khyarul/SENTINEL-MARK-II-QUEST/README.md

   
# SENTINEL MARK II (QUEST) - Line Follower Path Planning + Oled I2C User Interface
- Arduino compatible based on Maple Mini board (STM32F103CBT6)
- Burn and update firmware via USB-OTG
- BTS7960 motor driver 2 port + encoder
- OLED I2C SSD1306 128x64
- external eeprom (24LCxxx)
- 2 port for mini servo 5V
- 1 port for extinguisher motor (adjustable voltage using PWM) 
- external serial port (Serial1)

### Schematic (made using Kicad)
available in "Schematic" folder:
- SENTINEL Mark II - Quest.pro (Kicad Project)

### Gerber (3 board):
- Core + Driver motor: [Here](https://www.pcbway.com/project/shareproject/SENTINEL_mark_II__QUEST___Core___motor_driver_.html)
- Button + LCD: [Here](https://www.pcbway.com/project/shareproject/SENTINEL_mark_II__QUEST___button___eeprom___lcd_.html)
- Sensor: [Here](https://www.pcbway.com/project/shareproject/SENTINEL_mark_II__QUEST___Sensor_.html)

### Board Preview
SENTINEL Mark II - Quest
SENTINEL Mark II - Quest
SENTINEL Mark II - Quest bott
SENTINEL Mark II - Quest top
SENTINEL Mark II - Quest
SENTINEL Mark II - Quest
