khyarul/SENTINEL-MARK-II-QUEST/BOM List_mark2_rev0.xls

Ref | Qnty | Value | Battery | DC MOTOR | Bracket
C1, C5, C6, C9, C13, C18, C21, C22, C23, C24, C25, CM6 | 12 | 0805 100nF 50V | LiPo 3 cell 12.6V ~850mAh | 370 series or micro motor 12V | Acrylic
C2, C3, C4 | 3 | 0805 22uF 16V
C7, C8 | 2 | 0805 33uF 10V
C10 | 1 | 0805 3.9nF
C11, C12, C19, C20 | 4 | 0805 33pF
C14, C15, C16, C17 | 4 | 0805 1uF
CM1, CM2, CM3, CM5 | 4 | 0805 470nF 16V
CM4 | 1 | Cap Alu 100uF 16V ~6mmx8mm
D1, DM3 | 2 | SS34
D3 | 1 | SS54
D4 | 1 | 0805 LED
D5, DM2 | 2 | SS14
DM1 | 1 | Zener 5.1V
FB1, FB2, FB3, FB4, FB5, FB6, FB7 | 7 | 0805 Ferrite Bead 1A
FP1 | 1 | 1206 PTC fuse 2A
J1, J2, J3, J4, J5, J7, J8, J10, JP1, JM2 | 10 | Header Male Vertical 2.54mm
J6, J9 | 2 | Header Male Vertical 2.00mm
J11 | 1 | USB mini
JM1, JM3 | 2 | JST PH Horizontal 2.00mm
L1 | 1 | 10uH/4A ~7mm*7mm*3mm
LCD1 | 1 | LCD I2C OLED 128x64
LL1, LL2, LL3, LL4, LL5, LL6, LL7, LL8, LL9, LL10, LL11, LL12, LL13, LL14 | 14 | LED 3mm clear (white or green)
P1, P2, P3, P4, P5, P6, P7, P8, P9, P10, P11, P12, P13, P14 | 14 | photodiode 3mm
Q1, QM1 | 2 | MMBT3904
Q2 | 1 | MMBT3906
QM2 | 1 | AO3401
R1, R6, R8, R9, R12 | 5 | 0805 10K
R2 | 1 | 0805 100K
R3 | 1 | 0805 33K
R4, R20, R21, R22, R23, R24, R25, R26, R27, R28, R29, R30, R31, R32, R33 | 15 | 0805 6K8
R5, R10, R11, R34 | 4 | 0805 2K2
R7 | 1 | 0805 330
R13, R19 | 2 | 0805 1K
R14 | 1 | 0805 1K5
R15, R16 | 2 | 0805 0-22
R17, R18 | 2 | 0805 100
RM1, RM2, RM4, RM5, RM6, RM7, RM10, RM11, RM13, RM14 | 10 | 0805 10K
RM3, RM8, RM12, RM15 | 4 | SR
S1, | 1 | Slide switch 2.54mm
SW1, SW2, SW3, SW4, SW5, SW6, SW7 | 7 | SMD Push button max. 6mmx6mm
U1 | 1 | LM1117 3.3V / LD1117S33TR
U2 | 1 | MP2307
U3 | 1 | STM32F103CBTx
U4 | 1 | 24LC256 EEPROM
U5, U6 | 2 | 74HC4051 Multiplexer
UM1, UM2, UM3, UM4 | 4 | BTS7960
Y1 | 1 | 8MHz/20pF
