khyarul/SENTINEL-MARK-II-QUEST/(threads)

Thread 1 (2023-11-26):

Request for Assistance: Open Source Project Issues and Component Identification Challenge

Rakeshtsg, 2023-11-26:
Hello,

Firstly, thank you for your contribution to open-source projects. I'm currently encountering significant problems in RM3, RM8, RM12, and RM15|4|SR, where "resistor" was declared as SR. I'm unsure about SR's significance, so kindly provide a brief explanation of this issue.

Additionally, I'm having difficulty identifying components in images with components. Could you please share the file in .kicad_pcb format? Thank you.

Best regards.
issue.1
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
