khyarul/SENTINEL-MARK-II-QUEST/Schematic/LCD+Button+EEPROM.sch

## KiCad design Schematic/LCD+Button+EEPROM.sch (2020-10-01)

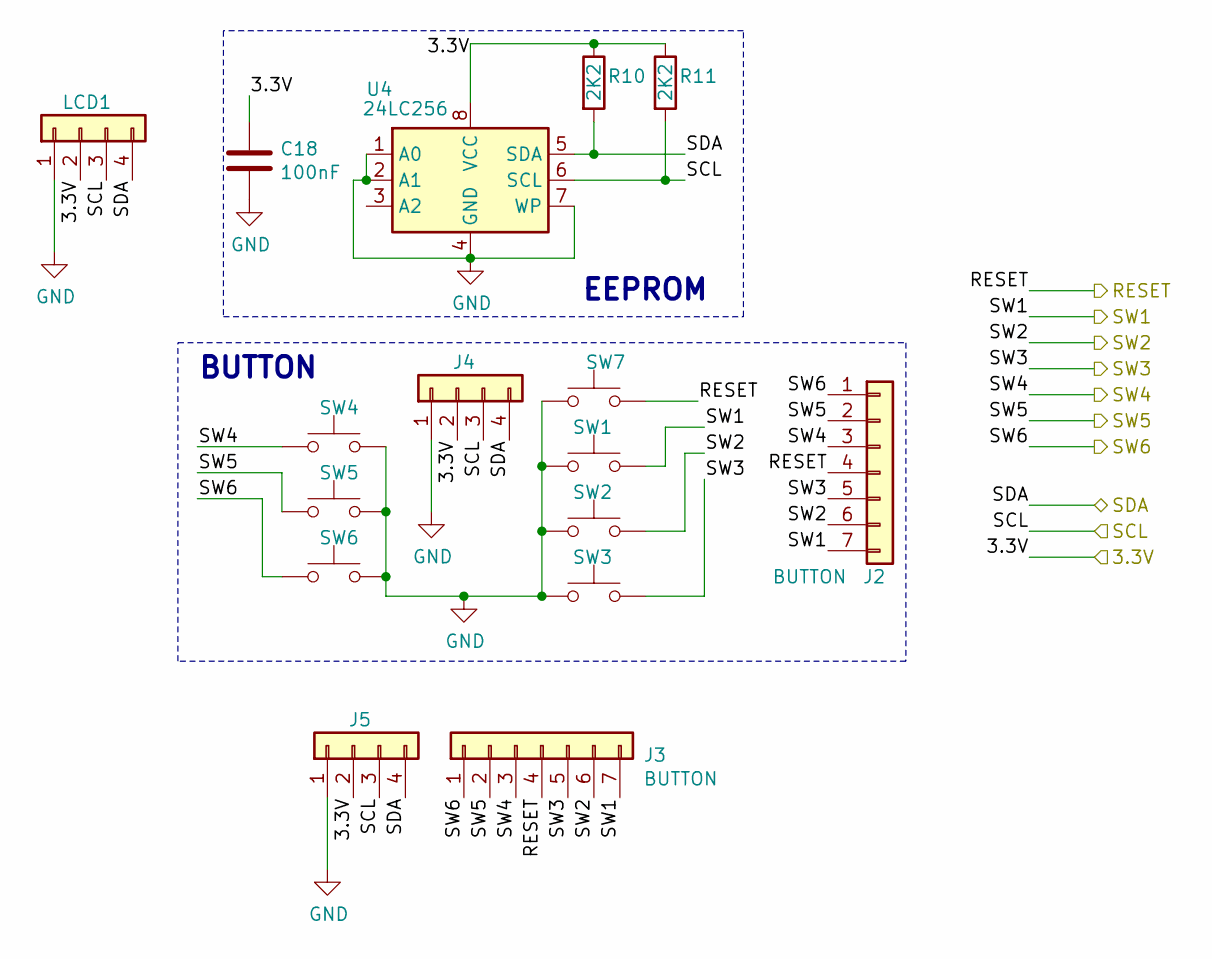
[picture p1: schematic LCD+Button+EEPROM.sch]

Parts:
C18: 100nF; C_0805_2012Metric
J2: BUTTON; PinSocket_1x07_P2.54mm_Vertical
J3: BUTTON; PinHeader_1x07_P2.54mm_Vertical
J4: Conn_01x04; PinHeader_1x04_P2.54mm_Vertical
J5: Conn_01x04; PinSocket_1x04_P2.54mm_Vertical
LCD1: LCD; OLED_I2C_128x64
R10, R11: 2K2; R_0805_2012Metric
SW1: B1; Push_button_silicon_mute
SW2: B2; Push_button_silicon_mute
SW3: B3; Push_button_silicon_mute
SW4: B4; Push_button_silicon_mute
SW5: B5; Push_button_silicon_mute
SW6: B6; Push_button_silicon_mute
SW7: RESET; Push_button_silicon_mute
U4: 24LC256; SO-8_3.9x4.9mm_P1.27mm

Connections:
3.3V: C18.1, J4.2, J5.2, LCD1.2, R10.1, R11.1, U4.8 (VCC)
GND: C18.2, J4.1, J5.1, LCD1.1, SW1.1, SW2.1, SW3.1, SW4.2, SW5.2, SW6.2, SW7.1, U4.1 (A0), U4.2 (A1), U4.4 (GND), U4.7 (WP)
RESET: J2.4, J3.4, SW7.2
SCL: J4.3, J5.3, LCD1.3, R11.2, U4.6 (SCL)
SDA: J4.4, J5.4, LCD1.4, R10.2, U4.5 (SDA)
SW1: J2.7, J3.7, SW1.2
SW2: J2.6, J3.6, SW2.2
SW3: J2.5, J3.5, SW3.2
SW4: J2.3, J3.3, SW4.1
SW5: J2.2, J3.2, SW5.1
SW6: J2.1, J3.1, SW6.1

Notes on the sheet:
EEPROM
BUTTON
