khyarul/SENTINEL-MARK-II-QUEST/Schematic/Motor Driver+Extinguisher.sch

## KiCad design Schematic/Motor Driver+Extinguisher.sch (2020-10-01)

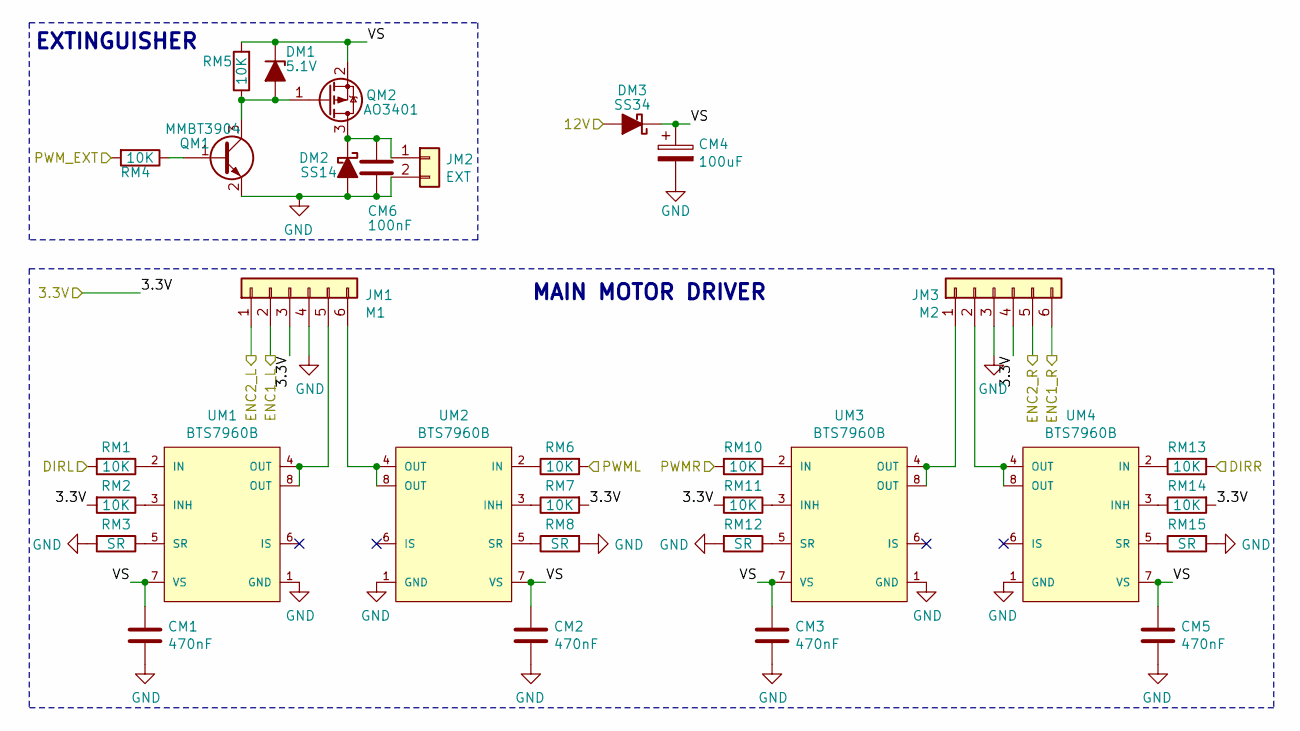
[picture p2: schematic Motor Driver+Extinguisher.sch]

Parts:
CM1, CM2, CM3, CM5: 470nF; C_0805_2012Metric
CM4: 100uF; CP_Elec_6.3x7.7
CM6: 100nF; C_0805_2012Metric
DM1: 5.1V; D_SOD-123
DM2: SS14; D_SMA
DM3: SS34; D_SMA
JM1: M1; JST_PH_S6B-PH-K_1x06_P2.00mm_Horizontal
JM2: EXT; PinHeader_1x02_P2.54mm_Vertical
JM3: M2; JST_PH_S6B-PH-K_1x06_P2.00mm_Horizontal
QM1: MMBT3904; SOT-23
QM2: AO3401; SOT-23
RM1, RM2, RM4, RM5, RM6, RM7, RM10, RM11, RM13, RM14: 10K; R_0805_2012Metric
RM3, RM8, RM12, RM15: SR; R_0805_2012Metric
UM1, UM2, UM3, UM4: BTS7960B; Infineon-BTS7960B-Level_A

Connections:
3.3V: JM1.3, JM3.4, RM2.2, RM7.2, RM11.2, RM14.2
12V: DM3.2 (A)
DIRL: RM1.2
DIRR: RM13.2
ENC1_L: JM1.2
ENC1_R: JM3.6
ENC2_L: JM1.1
ENC2_R: JM3.5
GND: CM1.2, CM2.2, CM3.2, CM4.2, CM5.2, CM6.2, DM2.2 (A), JM1.4, JM2.2, JM3.3, QM1.2 (E), RM3.2, RM8.2, RM12.2, RM15.2, UM1.1 (GND), UM2.1 (GND), UM3.1 (GND), UM4.1 (GND)
unnamed: CM6.1, DM2.1 (K), JM2.1, QM2.3 (D)
unnamed: DM1.2 (A), QM1.3 (C), QM2.1 (G), RM5.1
unnamed: JM1.5, UM1.4 (OUT), UM1.8 (OUT)
unnamed: JM1.6, UM2.4 (OUT), UM2.8 (OUT)
unnamed: JM3.1, UM3.4 (OUT), UM3.8 (OUT)
unnamed: JM3.2, UM4.4 (OUT), UM4.8 (OUT)
unnamed: QM1.1 (B), RM4.1
unnamed: RM1.1, UM1.2 (IN)
unnamed: RM2.1, UM1.3 (INH)
unnamed: RM3.1, UM1.5 (SR)
unnamed: RM6.1, UM2.2 (IN)
unnamed: RM7.1, UM2.3 (INH)
unnamed: RM8.1, UM2.5 (SR)
unnamed: RM10.1, UM3.2 (IN)
unnamed: RM11.1, UM3.3 (INH)
unnamed: RM12.1, UM3.5 (SR)
unnamed: RM13.1, UM4.2 (IN)
unnamed: RM14.1, UM4.3 (INH)
unnamed: RM15.1, UM4.5 (SR)
PWML: RM6.2
PWMR: RM10.2
PWM_EXT: RM4.2
VS: CM1.1, CM2.1, CM3.1, CM4.1, CM5.1, DM1.1 (K), DM3.1 (K), QM2.2 (S), RM5.2, UM1.7 (VS), UM2.7 (VS), UM3.7 (VS), UM4.7 (VS)

Notes on the sheet:
MAIN MOTOR DRIVER
EXTINGUISHER
