khyarul/SENTINEL-MARK-II-QUEST/Schematic/Power Supply.sch

## KiCad design Schematic/Power Supply.sch (2020-10-23)

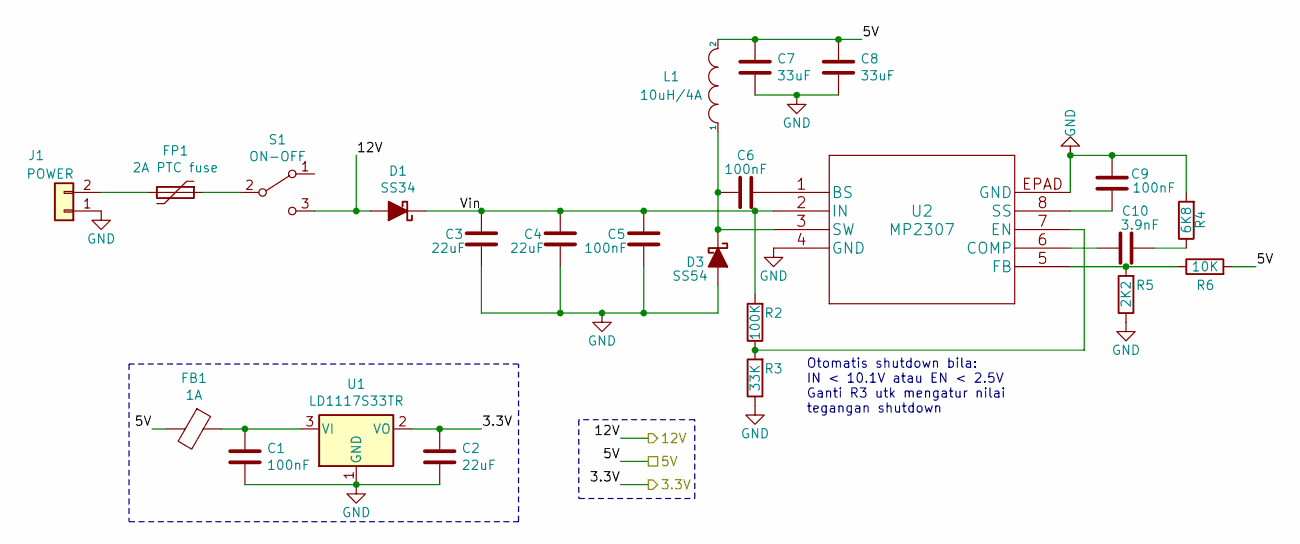
[picture p3: schematic Power Supply.sch]

Parts:
C1, C5, C6, C9: 100nF; C_0805_2012Metric
C2, C3, C4: 22uF; C_0805_2012Metric
C7, C8: 33uF; C_0805_2012Metric
C10: 3.9nF; C_0805_2012Metric
D1: SS34; D_SMA
D3: SS54; D_SMA
FB1: 1A; L_0805_2012Metric
FP1: 2A PTC fuse; Fuse_1206_3216Metric
J1: POWER; PinHeader_1x02_P2.54mm_Vertical
L1: 10uH/4A; L_7.3x7.3_H3.5
R2: 100K; R_0805_2012Metric
R3: 33K; R_0805_2012Metric
R4: 6K8; R_0805_2012Metric
R5: 2K2; R_0805_2012Metric
R6: 10K; R_0805_2012Metric
S1: ON-OFF; switch_slide_2.54
U1: LD1117S33TR; SOT-223-3_TabPin2
U2: MP2307

Connections:
3.3V: C2.1, U1.2 (VO)
5V: C7.1, C8.1, FB1.2, L1.2, R6.2
12V: D1.2 (A), S1.3 (C)
GND: C1.2, C2.2, C3.2, C4.2, C5.2, C7.2, C8.2, C9.2, D3.2 (A), J1.1, R3.1, R4.2, R5.1, U1.1 (GND), U2.4 (GND), U2.EPAD (GND)
unnamed: C1.1, FB1.1, U1.3 (VI)
unnamed: C6.1, U2.1 (BS)
unnamed: C6.2, D3.1 (K), L1.1, U2.3 (SW)
unnamed: C9.1, U2.8 (SS)
unnamed: C10.1, R4.1
unnamed: C10.2, U2.6 (COMP)
unnamed: FP1.1, S1.2 (B)
unnamed: FP1.2, J1.2
unnamed: R2.1, R3.2, U2.7 (EN)
unnamed: R5.2, R6.1, U2.5 (FB)
Vin: C3.1, C4.1, C5.1, D1.1 (K), R2.2, U2.2 (IN)

Notes on the sheet:
Otomatis shutdown bila: IN < 10.1V atau EN < 2.5V Ganti R3 utk mengatur nilai tegangan shutdown
