khyarul/SENTINEL-MARK-II-QUEST/Schematic/SENTINEL Mark II - Quest.sch

## KiCad design Schematic/SENTINEL Mark II - Quest.sch (2020-10-03)

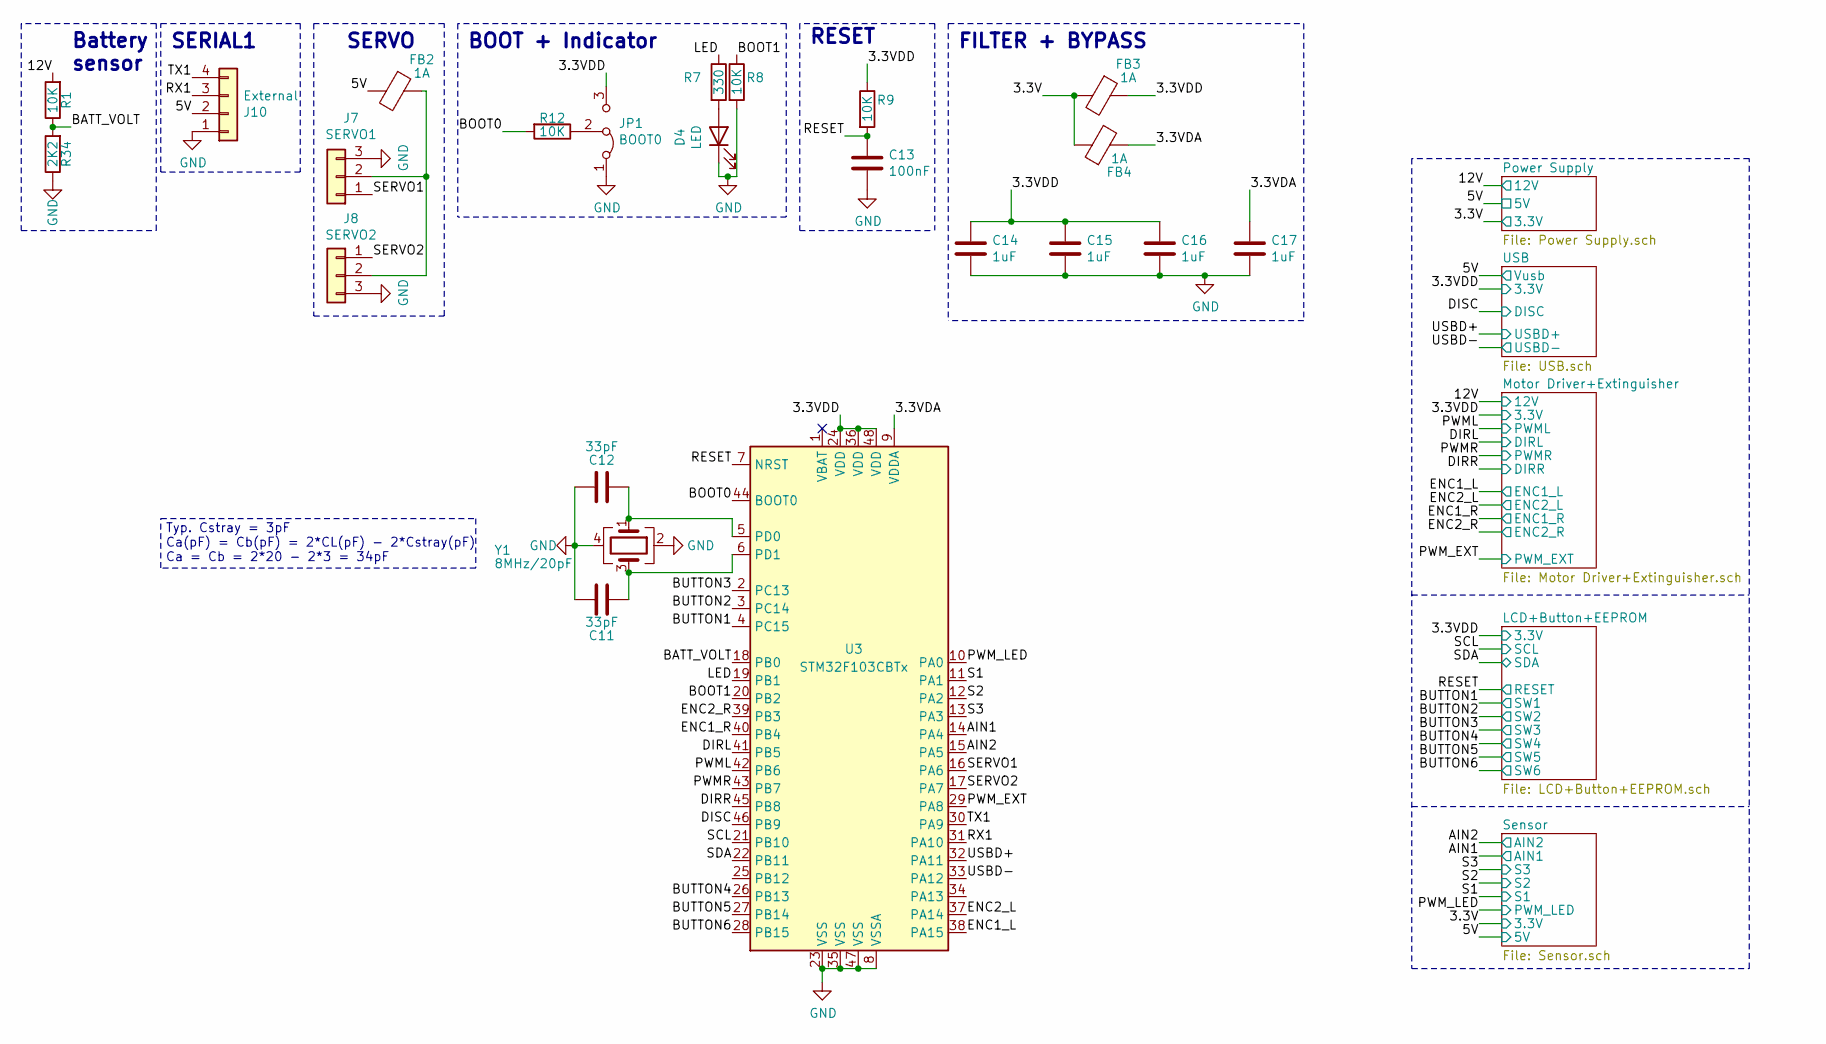
[picture p4: schematic SENTINEL Mark II - Quest.sch]

Parts:
C11, C12: 33pF; C_0805_2012Metric
C13: 100nF; C_0805_2012Metric
C14, C15, C16, C17: 1uF; C_0805_2012Metric
D4: LED; LED_0805_2012Metric
FB2, FB3, FB4: 1A; L_0805_2012Metric
J7: SERVO1; PinHeader_1x03_P2.54mm_Vertical
J8: SERVO2; PinHeader_1x03_P2.54mm_Vertical
J10: External; PinHeader_1x04_P2.54mm_Horizontal
JP1: BOOT0; PinHeader_1x03_P2.54mm_Vertical
R1, R8, R9, R12: 10K; R_0805_2012Metric
R7: 330; R_0805_2012Metric
R34: 2K2; R_0805_2012Metric
U3: STM32F103CBTx; LQFP-48_7x7mm_P0.5mm
Y1: 8MHz/20pF; Crystal_SMD_3225-4Pin_3.2x2.5mm_HandSoldering

Connections:
3.3V: FB3.2, FB4.1
3.3VDA: C17.1, FB4.2, U3.9 (VDDA)
3.3VDD: C14.1, C15.1, C16.1, FB3.1, JP1.3 (B), R9.1, U3.24 (VDD), U3.36 (VDD), U3.48 (VDD)
5V: FB2.2, J10.2
12V: R1.2
AIN1: U3.14 (PA4)
AIN2: U3.15 (PA5)
BATT_VOLT: R1.1, R34.2, U3.18 (PB0)
BOOT0: R12.2, U3.44 (BOOT0)
BOOT1: R8.1, U3.20 (PB2)
BUTTON1: U3.4 (PC15)
BUTTON2: U3.3 (PC14)
BUTTON3: U3.2 (PC13)
BUTTON4: U3.26 (PB13)
BUTTON5: U3.27 (PB14)
BUTTON6: U3.28 (PB15)
DIRL: U3.41 (PB5)
DIRR: U3.45 (PB8)
DISC: U3.46 (PB9)
ENC1_L: U3.38 (PA15)
ENC1_R: U3.40 (PB4)
ENC2_L: U3.37 (PA14)
ENC2_R: U3.39 (PB3)
GND: C11.1, C12.1, C13.2, C14.2, C15.2, C16.2, C17.2, D4.1 (K), J7.3, J8.3, J10.1, JP1.1 (A), R8.2, R34.1, U3.8 (VSSA), U3.23 (VSS), U3.35 (VSS), U3.47 (VSS), Y1.2, Y1.4
LED: R7.1, U3.19 (PB1)
unnamed: C11.2, U3.6 (PD1), Y1.3
unnamed: C12.2, U3.5 (PD0), Y1.1
unnamed: D4.2 (A), R7.2
unnamed: FB2.1, J7.2, J8.2
unnamed: JP1.2 (C), R12.1
PWML: U3.42 (PB6)
PWMR: U3.43 (PB7)
PWM_EXT: U3.29 (PA8)
PWM_LED: U3.10 (PA0)
RESET: C13.1, R9.2, U3.7 (NRST)
RX1: J10.3, U3.31 (PA10)
S1: U3.11 (PA1)
S2: U3.12 (PA2)
S3: U3.13 (PA3)
SCL: U3.21 (PB10)
SDA: U3.22 (PB11)
SERVO1: J7.1, U3.16 (PA6)
SERVO2: J8.1, U3.17 (PA7)
TX1: J10.4, U3.30 (PA9)
USBD+: U3.32 (PA11)
USBD-: U3.33 (PA12)

Notes on the sheet:
Typ. Cstray = 3pF Ca(pF) = Cb(pF) = 2*CL(pF) - 2*Cstray(pF) Ca = Cb = 2*20 - 2*3 = 34pF
SERVO
FILTER + BYPASS
BOOT + Indicator
RESET
SERIAL1
Battery sensor
