khyarul/SENTINEL-MARK-II-QUEST/Schematic/Sensor.sch

## KiCad design Schematic/Sensor.sch (2020-10-03)

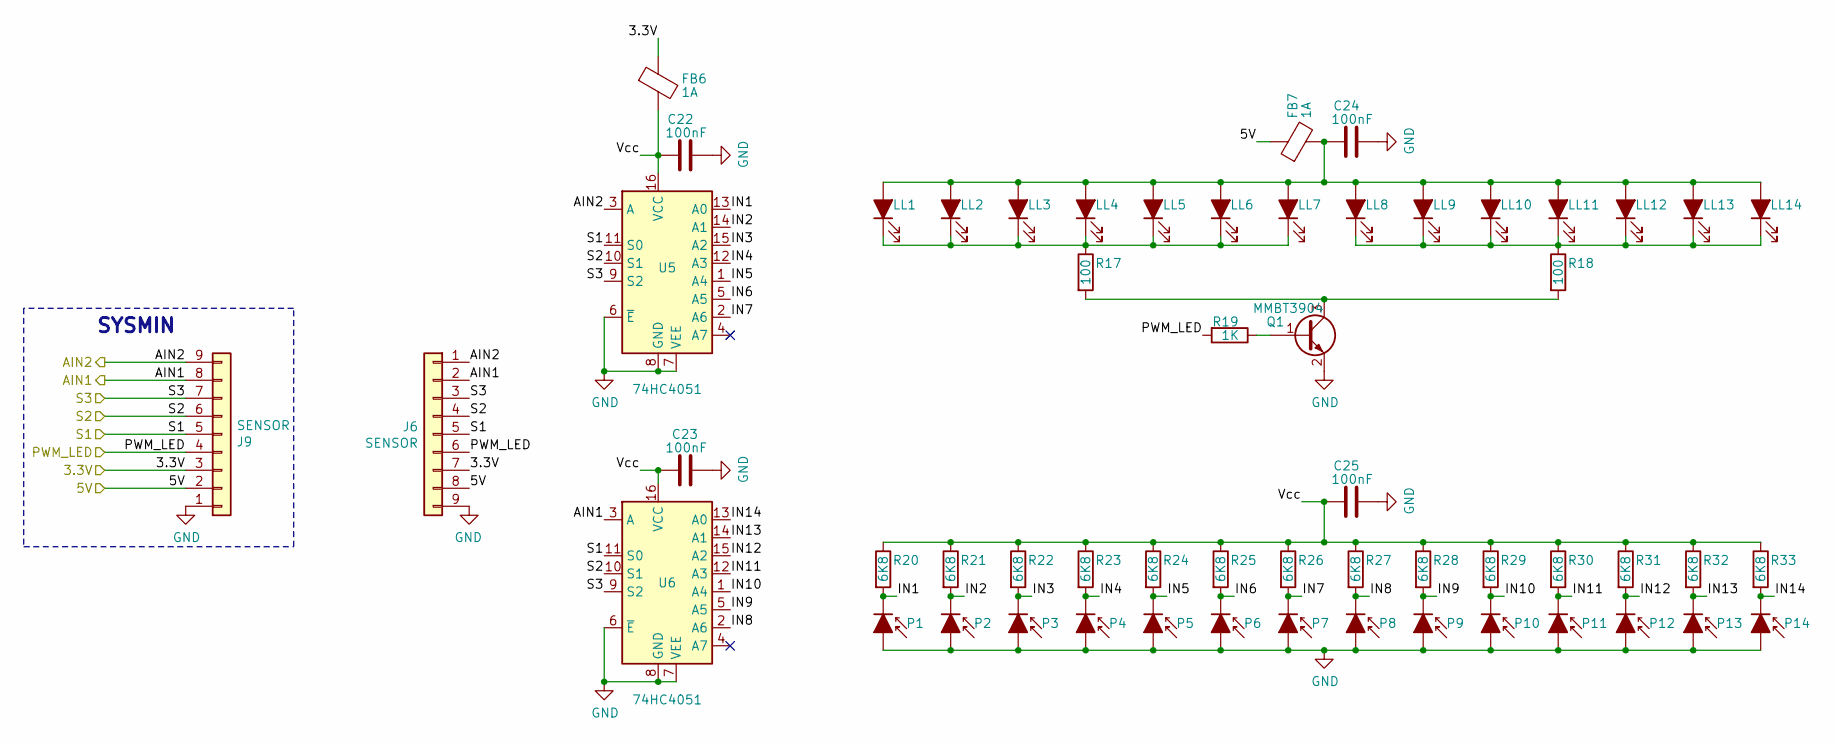
[picture p5: schematic Sensor.sch]

Parts:
C22, C23, C24, C25: 100nF; C_0805_2012Metric
FB6, FB7: 1A; L_0805_2012Metric
J6, J9: SENSOR; PinHeader_1x09_P2.00mm_Vertical
LL1, LL2, LL3, LL4, LL5, LL6, LL7, LL8, LL9, LL10, LL11, LL12, LL13, LL14: LED_ALT; LED_D3.0mm_Clear
P1, P2, P3, P4, P5, P6, P7, P8, P9, P10, P11, P12, P13, P14: D_Photo_ALT; LED_D3.0mm_IRGrey
Q1: MMBT3904; SOT-23
R17, R18: 100; R_0805_2012Metric
R19: 1K; R_0805_2012Metric
R20, R21, R22, R23, R24, R25, R26, R27, R28, R29, R30, R31, R32, R33: 6K8; R_0805_2012Metric
U5, U6: 74HC4051; SOIC-16_3.9x9.9mm_P1.27mm

Connections:
3.3V: FB6.1, J6.7, J9.3
5V: FB7.1, J6.8, J9.2
AIN1: J6.2, J9.8, U6.3 (A)
AIN2: J6.1, J9.9, U5.3 (A)
GND: C22.2, C23.2, C24.2, C25.2, J6.9, J9.1, P1.2 (A), P2.2 (A), P3.2 (A), P4.2 (A), P5.2 (A), P6.2 (A), P7.2 (A), P8.2 (A), P9.2 (A), P10.2 (A), P11.2 (A), P12.2 (A), P13.2 (A), P14.2 (A), Q1.2 (E), U5.6 (~E), U5.7 (VEE), U5.8 (GND), U6.6 (~E), U6.7 (VEE), U6.8 (GND)
IN1: P1.1 (K), R20.2, U5.13 (A0)
IN2: P2.1 (K), R21.2, U5.14 (A1)
IN3: P3.1 (K), R22.2, U5.15 (A2)
IN4: P4.1 (K), R23.2, U5.12 (A3)
IN5: P5.1 (K), R24.2, U5.1 (A4)
IN6: P6.1 (K), R25.2, U5.5 (A5)
IN7: P7.1 (K), R26.2, U5.2 (A6)
IN8: P8.1 (K), R27.2, U6.2 (A6)
IN9: P9.1 (K), R28.2, U6.5 (A5)
IN10: P10.1 (K), R29.2, U6.1 (A4)
IN11: P11.1 (K), R30.2, U6.12 (A3)
IN12: P12.1 (K), R31.2, U6.15 (A2)
IN13: P13.1 (K), R32.2, U6.14 (A1)
IN14: P14.1 (K), R33.2, U6.13 (A0)
unnamed: C24.1, FB7.2, LL1.2 (A), LL2.2 (A), LL3.2 (A), LL4.2 (A), LL5.2 (A), LL6.2 (A), LL7.2 (A), LL8.2 (A), LL9.2 (A), LL10.2 (A), LL11.2 (A), LL12.2 (A), LL13.2 (A), LL14.2 (A)
unnamed: LL1.1 (K), LL2.1 (K), LL3.1 (K), LL4.1 (K), LL5.1 (K), LL6.1 (K), LL7.1 (K), R17.1
unnamed: LL8.1 (K), LL9.1 (K), LL10.1 (K), LL11.1 (K), LL12.1 (K), LL13.1 (K), LL14.1 (K), R18.1
unnamed: Q1.1 (B), R19.1
unnamed: Q1.3 (C), R17.2, R18.2
PWM_LED: J6.6, J9.4, R19.2
S1: J6.5, J9.5, U5.11 (S0), U6.11 (S0)
S2: J6.4, J9.6, U5.10 (S1), U6.10 (S1)
S3: J6.3, J9.7, U5.9 (S2), U6.9 (S2)
Vcc: C22.1, C23.1, C25.1, FB6.2, R20.1, R21.1, R22.1, R23.1, R24.1, R25.1, R26.1, R27.1, R28.1, R29.1, R30.1, R31.1, R32.1, R33.1, U5.16 (VCC), U6.16 (VCC)

Notes on the sheet:
SYSMIN
