khyarul/SENTINEL-MARK-II-QUEST/Schematic/USB.sch

## KiCad design Schematic/USB.sch (2020-10-23)

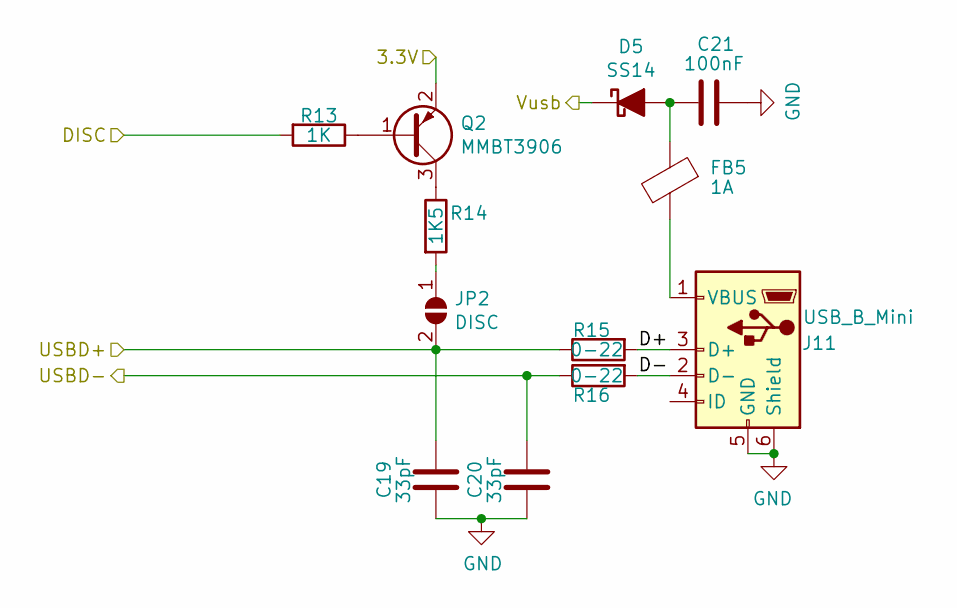
[picture p6: schematic USB.sch]

Parts:
C19, C20: 33pF; C_0805_2012Metric
C21: 100nF; C_0805_2012Metric
D5: SS14; D_SMA
FB5: 1A; L_0805_2012Metric
J11: USB_B_Mini; USB_Mini-B_Lumberg_2486_01_Horizontal
JP2: DISC; SolderJumper-2_P1.3mm_Open_RoundedPad1.0x1.5mm
Q2: MMBT3906; SOT-23
R13: 1K; R_0805_2012Metric
R14: 1K5; R_0805_2012Metric
R15, R16: 0-22; R_0805_2012Metric

Connections:
3.3V: Q2.2 (E)
D+: J11.3 (D+), R15.2
D-: J11.2 (D-), R16.2
DISC: R13.2
GND: C19.2, C20.2, C21.1, J11.5 (GND), J11.6 (Shield)
unnamed: C21.2, D5.2 (A), FB5.1
unnamed: FB5.2, J11.1 (VBUS)
unnamed: JP2.1 (A), R14.2
unnamed: Q2.1 (B), R13.1
unnamed: Q2.3 (C), R14.1
USBD+: C19.1, JP2.2 (B), R15.1
USBD-: C20.1, R16.1
Vusb: D5.1 (K)
