khyarul/SENTINEL-MARK-II-QUEST/Firmware/sentinel_main/sentinel_button.ino

void initButton() {
  pinMode(PB13, INPUT_PULLUP);
  pinMode(PB14, INPUT_PULLUP);
  pinMode(PB15, INPUT_PULLUP);
  pinMode(PC13, INPUT_PULLUP);
  pinMode(PC14, INPUT_PULLUP);
  pinMode(PC15, INPUT_PULLUP);
}
