khyarul/SENTINEL-MARK-II-QUEST/(commit log)

2020-09-19 KICAD schematic
    [LCD+Button+EEPROM.sch, Motor Driver+Extinguisher.sch, Power Supply.sch, SENTINEL Mark II - Quest.kicad_pcb, SENTINEL Mark II - Quest.sch, USB.sch]
2020-09-19 Footprint Assigned
    [LCD+Button+EEPROM.sch, Motor Driver+Extinguisher.sch, Power Supply.sch, SENTINEL Mark II - Quest.sch, USB.sch]
2020-09-20 Add new file
    edge-cut.cdr
    [Motor Driver+Extinguisher.sch, SENTINEL Mark II - Quest.kicad_pcb]
2020-09-20 PCB Edge-cute line
    PCB Edge-cute line/milling/outer line
2020-09-22 PCB Edge-cut
    [edge-cut.dxf]
2020-09-27 Circuit fix (Kicad)
    [LCD+Button+EEPROM.sch, Motor Driver+Extinguisher.sch, Power Supply.sch, SENTINEL Mark II - Quest.kicad_pcb, SENTINEL Mark II - Quest.sch, USB.sch, edge-cut.dxf]
2020-10-01 Gerber File
2020-10-01 gerber button + lcd
2020-10-01 sensor Schematic added
    [LCD+Button+EEPROM.sch, Motor Driver+Extinguisher.sch, Power Supply.sch, SENTINEL Mark II - Quest.sch, Sensor.sch, USB.sch]
2020-10-01 Gerber moved to PCBway
2020-10-01 Added sensor schematic
    [LCD+Button+EEPROM.sch, Motor Driver+Extinguisher.sch, Power Supply.sch, SENTINEL Mark II - Quest.sch, Sensor.sch, USB.sch]
2020-10-03 Schematic Kicad
    + voltage divider (for battery sensor)
    [SENTINEL Mark II - Quest.sch, Sensor.sch]
2020-10-13 BOM/Part list
    [BOM List.xls]
2020-10-23 Part list
    [BOM List.xls, BOM List_mark2_rev0.xls]
2020-10-23 Schematic update
    [Power Supply.sch, USB.sch]
2021-09-26 Firmware
    The reading of the sensor error value is already using "Mean Error" algorithm
    No longer using manual method "switch case"
    -------------------------------------------------------------------------------------
    Pembacaan nilai error sensor sudah menggunakan algoritma "Mean Error"
    Tidak lagi menggunakan metode manual "switch case"
    [sentinel_button.ino, sentinel_encoder.ino, sentinel_main.ino, sentinel_menu.ino, sentinel_motor.ino, sentinel_sensor.ino]
